experimentool/STM32INA219OLED1/Schematic_STM32INA219OLED1_Sheet_1_20191021193512.pdf

## arduino ide sketch name stm32ina219withoriginalshunt.ino

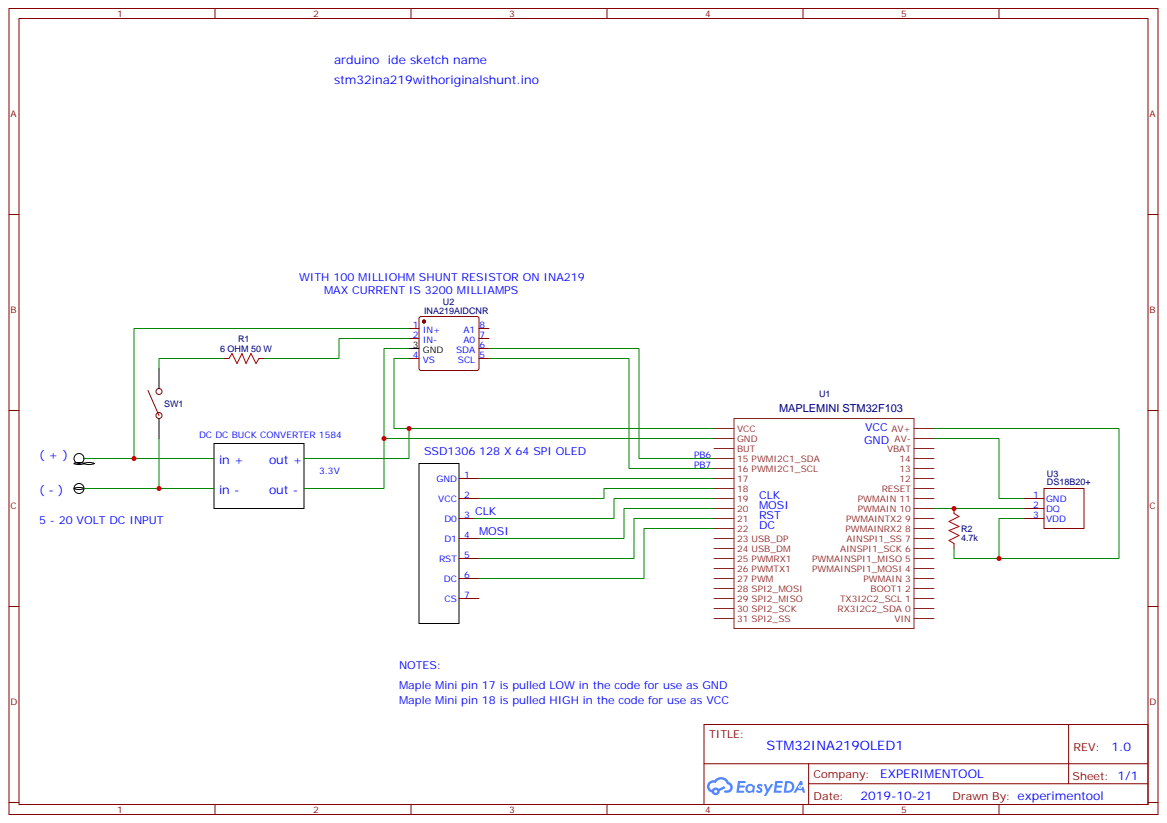
[picture p4: page 1]

WITH 100 MILLIOHM SHUNT RESISTOR ON INA219
MAX CURRENT IS 3200 MILLIAMPS

DC DC BUCK CONVERTER 1584

NOTES:
Maple Mini pin 17 is pulled LOW in the code for use as GND
Maple Mini pin 18 is pulled HIGH in the code for use as VCC
